tei06398/VisiStick-Arduino/Notes Worth Taking.docx

Notes Worth Taking

- Get a prototype
- Have a high success rate (at least 80%)
- Pick objects worth testing on
- What makes the test fail
