tei06398/VisiStick-Arduino/Stuff for Break.docx

https://www.homedepot.com/p/Everbilt-3-16-in-x-12-in-Cold-Rolled-Plain-Round-Rod-800407/204325644

https://basiccopper.com/thicknessguide.html
