tei06398/VisiStick-Arduino/Web Links.docx

Smart Cane (https://www.researchgate.net/publication/302405276_The_Smartcane_for_Blind_People_An_Electronically_Smart_Stick_to_Aid_Mobility)

Wet Surfaces Stats (https://safestart.com/news/heres-why-safety-pros-dont-stop-more-slips-trips-and-falls-happening-work/)

Falling (https://www.visionaware.org/blog/visually-impaired-now-what/protect-your-independence-create-a-fall-prevention-plan/12)

Blind Paths (https://psuchina.wordpress.com/2012/07/27/blind-lanes-in-china/)

Smart Cane 2 (http://assistech.iitd.ernet.in/smartcane.php)

Papers & Patents (http://assistech.iitd.ernet.in/index.php)

Sensors (https://www.intorobotics.com/types-sensors-target-detection-tracking/)

SmartCane Handle Patent

SHARP 2Y0A02 Datasheet (https://www.sparkfun.com/datasheets/Sensors/Infrared/gp2y0a02yk_e.pdf)
