tei06398/VisiStick-Arduino/Documents/Patents.docx

Patents

- Cane Handle (We are making our own handle)
- Axial Interlocking Cane (Not found)
- Split Architecture Design (Our sensor is not requiring other components to add onto the cane)
- Sensor Usage (Not an issue as the SmartCane sensor is on the handle while ours is not)
- Laser Radar Imaging - Object Detection: US20080309913A1 (We are not using lasers)
