tei06398/VisiStick-Arduino/Mechanics/Important Equations.docx

Important Equations:

Cg = m1x1 * m2x2…/ m(total)

Cg - Center of Gravity

m - Mass

x - Distance
