tei06398/VisiStick-Arduino/VisiStick (Inventor)/Electronics/ASM - Breakout Board Micro B.jpg

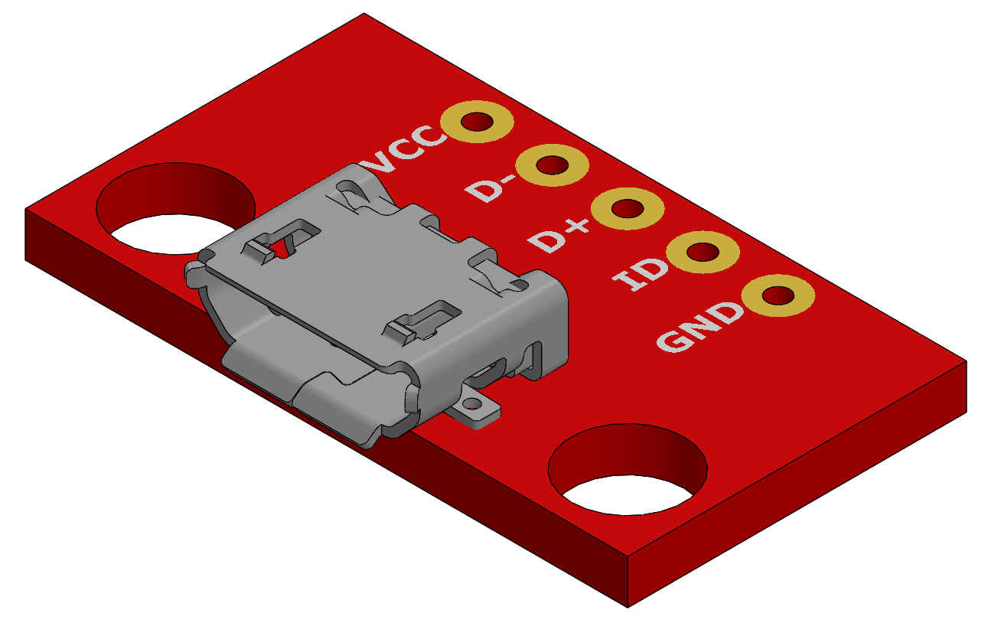
VisiStick (Inventor)/Electronics/ASM - Breakout Board Micro B.jpg
