tei06398/VisiStick-Arduino/Documents/Expenses.xlsx

Sheet: Expense Report
Begin Cumulative Labor Costs |  | Total Labor Costs: |  | $3373.50
Name |  | Hours | Hourly | Cost | Running Total
Seth |  | 112 | $10.00 | $1120.00 | $1120.00
Kyle |  | 107.25 | $10.00 | $1072.50 | $2192.50
DeSimony |  | 11.4 | $40.00 | $456.00 | $2648.50
Fitzgerald |  | 18.125 | $40.00 | $725.00 | $3373.50
End Cumulative Labor Costs
Part | Part Number | Quantity | Unit Price | Cost | Running Total | Section | Order
Begin Preexisting Parts
Arduino UNO | A000066 | 1 | $22.00 | $22.00 | $3395.50 | $22.00
Sharp Lidar Sensor | GP2Y0A02YK0F | 1 | $14.95 | $14.95 | $3410.45 | $36.95
End Preexisting Parts |  |  |  |  | $3410.45 |  | $36.95
Begin First DigiKey Order (12/18/18) (Sales Order #57795645) |  |  |  |  | $3410.45
Bluefruit LE UART Friend | 1528-1350-ND | 1 | $17.50 | $17.50 | $3427.95 | $17.50
LiIon Charger Board | 1528-1833-ND | 1 | $6.95 | $6.95 | $3434.90 | $24.45
USB C Breakout | 1568-1958-ND | 1 | $4.50 | $4.50 | $3439.40 | $28.95
USB MicroB Breakout | 1568-1192-ND | 1 | $4.25 | $4.25 | $3443.65 | $33.20
Battery 3.7V 2.5AH | 1528-1840-ND | 1 | $14.95 | $14.95 | $3458.60 | $48.15
Boost Converter | 1568-1155-ND | 1 | $15.95 | $15.95 | $3474.55 | $64.10
JST 2 Pin Cable | 1528-1126-ND | 1 | $0.75 | $0.75 | $3475.30 | $64.85
Rocker Switch | CH807-ND | 1 | $1.27 | $1.27 | $3476.57 | $66.12
End First DigiKey Order |  |  |  |  | $3476.57 |  | $66.12
Begin Home Depot Purchase (2/25/19) |  |  |  |  | $3476.57
Red Electrical Tape |  | 1 | $3.98 | $3.98 | $3480.55 | $3.98
WD-40 8 OZ |  | 1 | $4.27 | $4.27 | $3484.82 | $8.25
3 Foot 3/16" Dia. Steel Rod |  | 1 | $2.77 | $2.77 | $3487.59 | $11.02
Sales Tax |  | 1 | $0.88 | $0.88 | $3488.47 | $11.90
End Home Depot Purchase |  |  |  |  | $3488.47 |  | $11.90
Begin Michael's Purchase (2/25/19) |  |  |  |  | $3488.47
Copper Tape |  | 1 | $7.49 | $7.49 | $3495.96 | $7.49
Sales Tax |  | 1 | $0.60 | $0.60 | $3496.56 | $8.09
End Michael's Purchase |  |  |  |  | $3496.56 |  | $8.09
Begin Machining Job 1 (5/9/19)
.118" Lexan |  | 7.125 in2 | ?
.24" Lexan |  | 40 in2 | ?

Sheet: Hours Tracking
Date | Seth | Kyle | DeSimony | Fitzgerald | Cumulative Hours
2019-09-05 | 1.25 | 1.25 | 0 | 0 | Seth | Kyle | DeSimony | Fitzgerald
2019-09-07 | 1.25 | 1.25 | 0 | 0 | 112 | 107.25 | 11.4 | 18.125
2019-09-11 | 1.25 | 1.25 | 0 | 0
2019-09-13 | 1.25 | 1.25 | 0 | 0
2019-09-17 | 1.25 | 1.25 | 0 | 0
2019-09-19 | 1.25 | 1.25 | 0 | 0
2019-09-21 | 1.25 | 1.25 | 0 | 0
2019-09-25 | 1.25 | 1.25 | 0 | 0
2019-09-27 | 1.25 | 1.25 | 0 | 0
2019-10-01 | 1.25 | 1.25 | 0 | 0
2019-10-03 | 1.25 | 1.25 | 0 | 0
2019-10-05 | 1.25 | 1.25 | 0 | 0
2019-10-09 | 1.25 | 1.25 | 0 | 0
2019-10-11 | 1.25 | 0 | 0 | 0
2019-10-15 | 1.25 | 0 | 0 | 0
2019-10-17 | 1.25 | 0 | 0 | 0
2019-10-19 | 1.25 | 0 | 0 | 0
2019-10-23 | 1.25 | 0 | 0 | 0
2019-10-25 | 1.25 | 1.25 | 0 | 0
2019-10-29 | 1.25 | 1.25 | 0 | 0
2019-10-31 | 1.25 | 1.25 | 0 | 0
2019-11-02 | 1.25 | 1.25 | 0 | 0
2019-11-06 | 1.25 | 1.25 | 0 | 0
2019-11-08 | 1.25 | 1.25 | 0 | 0
2019-11-27 | 1.25 | 1.25 | 0 | 0
2019-11-29 | 1.25 | 1.25 | 0 | 0
2019-12-03 | 1.25 | 1.25 | 0 | 0
2019-12-05 | 1.25 | 1.25 | 0 | 0
2019-12-07 | 1.25 | 1.25 | 0 | 0
2019-12-11 | 1.25 | 1.25 | 0 | 0
2019-12-13 | 1.25 | 1.25 | 0 | 0
2019-12-17 | 1.25 | 1.25 | 0 | 0
2019-12-19 | 1.25 | 1.25 | 0 | 0
2019-12-21 | 1.25 | 1.25 | 0 | 0
2019-01-03 | 1.25 | 1.25 | 0 | 0
2019-01-07 | 1.25 | 1.25 | 0 | 0
2019-01-09 | 1.25 | 1.25 | 0 | 0
2019-01-11 | 1.25 | 1.25 | 0 | 0
2019-01-15 | 1.25 | 1.25 | 0 | 0
2019-01-17 | 1.25 | 1.25 | 0 | 0
2019-01-28 | 1.25 | 1.25 | 0 | 0
2019-01-30 | 0 | 1.25 | 0 | 0
2019-02-04 | 1.25 | 1.25 | 0 | 1.25
2019-02-05 | 0.5 | 0 | 0 | 0
2019-02-06 | 1.25 | 1.25 | 0 | 0.75
2019-02-08 | 1.25 | 2.5 | 0 | 1.25
2019-02-11 | 1.25 | 1.25 | 0.5 | 0.75
2019-02-13 | 1 | 1 | 0 | 0
2019-02-15 | 1.25 | 2.5 | 0 | 0
2019-02-25 | 3 | 3 | 0 | 0
2019-02-26 | 1.25 | 2.5 | 0 | 0
2019-02-27 | 1.25 | 0.75 | 0 | 0
2019-02-28 | 1.25 | 0 | 0 | 0
2019-03-04 | 1.25 | 1.25 | 0 | 0.75
2019-03-05 | 0.75 | 0 | 0 | 0
2019-03-06 | 1.25 | 2 | 0 | 0
2019-03-08 | 1.25 | 5 | 1 | 1
2019-03-12 | 1.25 | 1.25 | 0 | 0.75
2019-03-14 | 1.25 | 2 | 0.5 | 0.5
2019-03-18 | 1.25 | 2.5 | 0.5 | 0.5
2019-03-19 | 1 | 0 | 0 | 0
2019-03-20 | 1.25 | 2.5 | 0.5 | 0.25
2019-03-21 | 0 | 0.75 | 0 | 0
2019-03-25 | 1.25 | 1.25 | 0 | 1
2019-03-26 | 0.5 | 0 | 0 | 0
2019-03-27 | 2 | 2.5 | 0.75 | 1.25
2019-03-28 | 0.5 | 0 | 0 | 0
2019-03-29 | 1.25 | 2.5 | 1 | 1
2019-04-02 | 1.25 | 2.5 | 0 | 0
2019-04-04 | 1.25 | 2.5 | 0.75 | 1.25
2019-04-07 | 0.75 | 0 | 0 | 0
2019-04-08 | 2 | 1.25 | 0.25 | 0
2019-04-09 | 0.75 | 0 | 0 | 0
2019-04-10 | 2 | 0 | 0 | 0.75
2019-04-11 | 0.75 | 0 | 0 | 0
2019-04-12 | 2 | 2.5 | 0 | 0
2019-04-13 | 1.5 | 0 | 0 | 0
2019-04-14 | 1.5 | 0 | 0 | 0
2019-04-15 | 1 | 0 | 0 | 0
2019-04-16 | 2.75 | 1.25 | 0.375 | 0.375
2019-04-18 | 0 | 2 | 0.5 | 0
2019-04-30 | 3 | 2 | 0.375 | 0.5
2019-05-01 | 2.5 | 0 | 0 | 0
2019-05-02 | 1.25 | 2 | 0.5 | 1
2019-05-06 | 1.25 | 1.25 | 0.9 | 0.75
2019-05-07 | 1.25 | 0 | 0 | 0
2019-05-08 | 1.25 | 0.5 | 0.5 | 1
2019-05-09 | 0.5 | 2.5 | 2 | 1
2019-05-10 | 1.75 | 1.25 | 0.5 | 0.5
