tei06398/VisiStick-Arduino/VisiStick (Inventor)/Electronics/ASM - Breakout Board Micro B.STEP

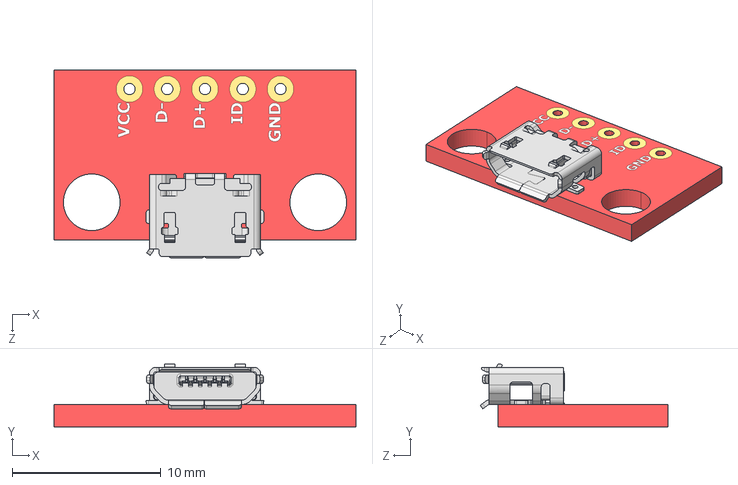
[picture p2: CAD file, 2019-10-01]
VisiStick (Inventor)/Electronics/ASM - Breakout Board Micro B.STEP
20.3 x 4.21 x 12.6 mm
Parts - PCB
Parts - micro_B
