tei06398/VisiStick-Arduino/VisiStick (Inventor)/Electronics/Parts - PCB.SLDPRT

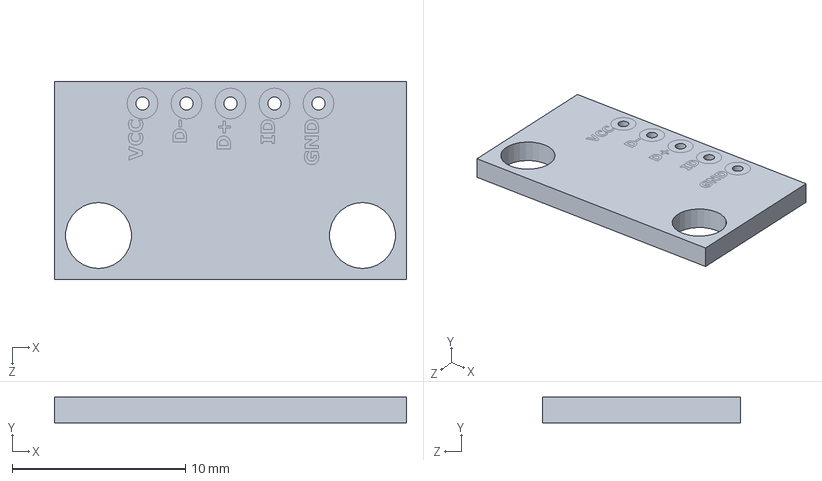
[picture p3: CAD file, 2019-10-01]
VisiStick (Inventor)/Electronics/Parts - PCB.SLDPRT
20.3 x 1.50 x 11.4 mm
