tei06398/VisiStick-Arduino/VisiStick (Inventor)/Electronics/S2B-PH-SM4-TB.SLDPRT

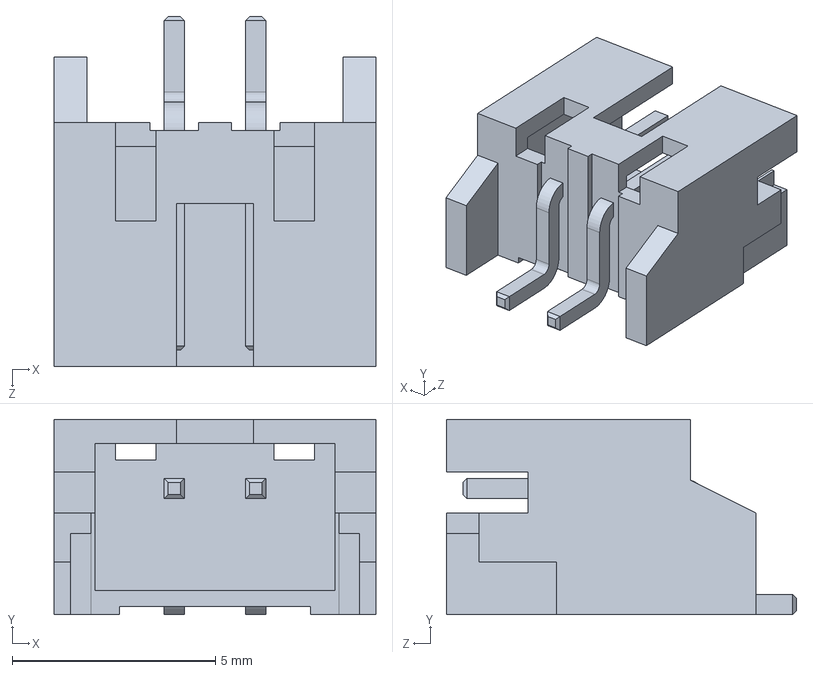
[picture p4: CAD file, 2019-10-01]
VisiStick (Inventor)/Electronics/S2B-PH-SM4-TB.SLDPRT
7.90 x 4.80 x 8.60 mm
