tei06398/VisiStick-Arduino/VisiStick (Inventor)/Electronics/.100 Header.SLDPRT

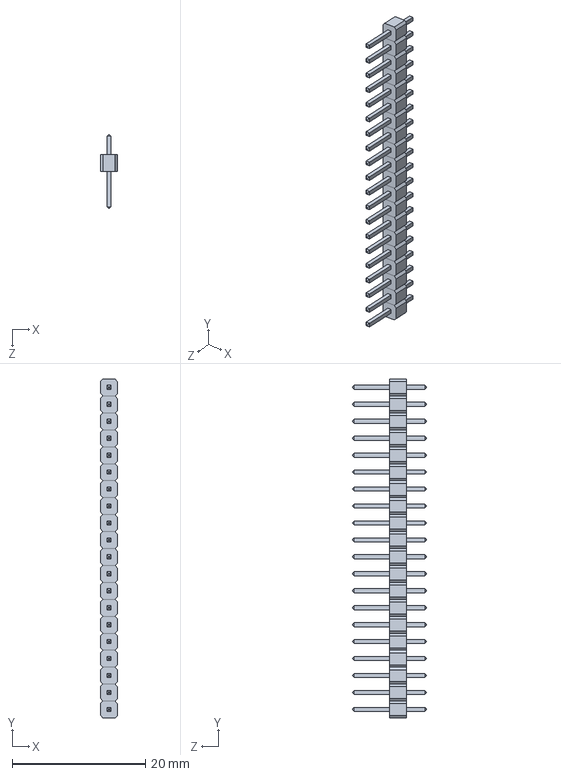
[picture p5: CAD file, 2019-10-01]
VisiStick (Inventor)/Electronics/.100 Header.SLDPRT
2.54 x 50.8 x 11.1 mm
