tei06398/VisiStick-Arduino/VisiStick (Inventor)/Electronics/Adafruit Micro Lipo wMicroUSB Jack - USB LiIonLiPoly charger.STEP

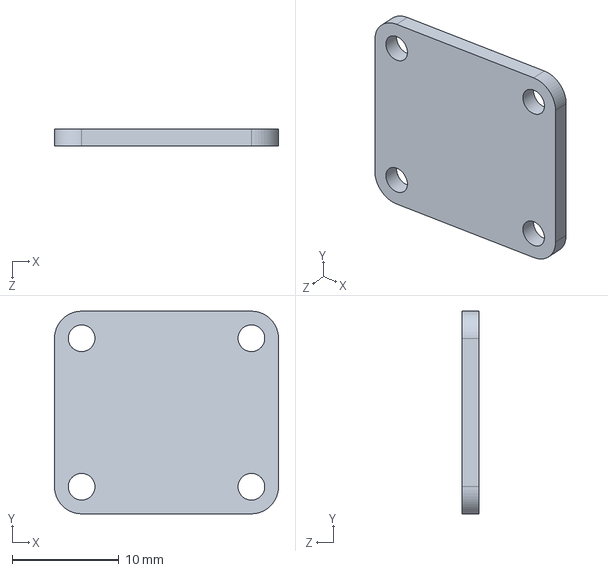
[picture p6: CAD file, 2019-10-01]
VisiStick (Inventor)/Electronics/Adafruit Micro Lipo wMicroUSB Jack - USB LiIonLiPoly charger.STEP
21.0 x 19.0 x 1.59 mm
