tei06398/VisiStick-Arduino/VisiStick (Inventor)/Electronics/Parts - micro_B.SLDPRT

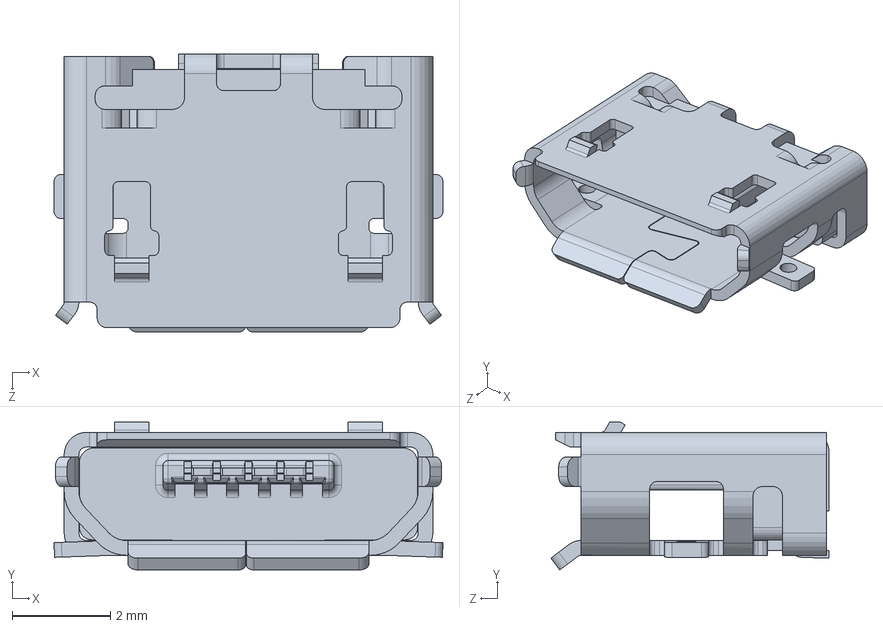
[picture p7: CAD file, 2019-10-01]
VisiStick (Inventor)/Electronics/Parts - micro_B.SLDPRT
7.91 x 3.01 x 5.66 mm
