tei06398/VisiStick-Arduino/VisiStick (Inventor)/Electronics/SPDT 30A switch.stp

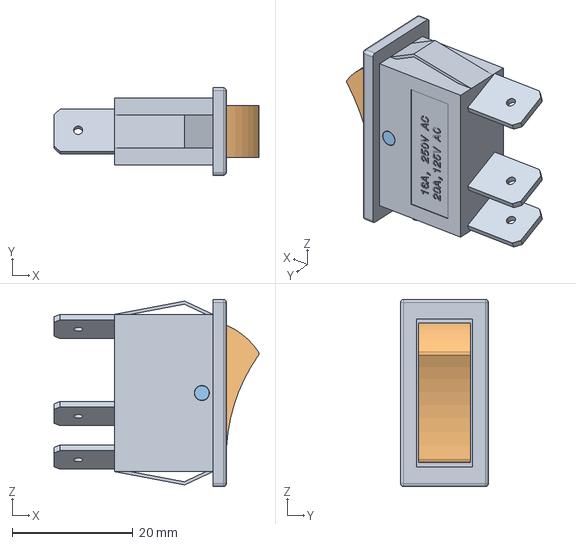
[picture p8: CAD file, 2019-10-01]
VisiStick (Inventor)/Electronics/SPDT 30A switch.stp
33.9 x 14.5 x 31.0 mm
