tei06398/VisiStick-Arduino/VisiStick (Inventor)/Electronics/Hirose Micro USB Digikey PN H11635CT-ND.SLDPRT

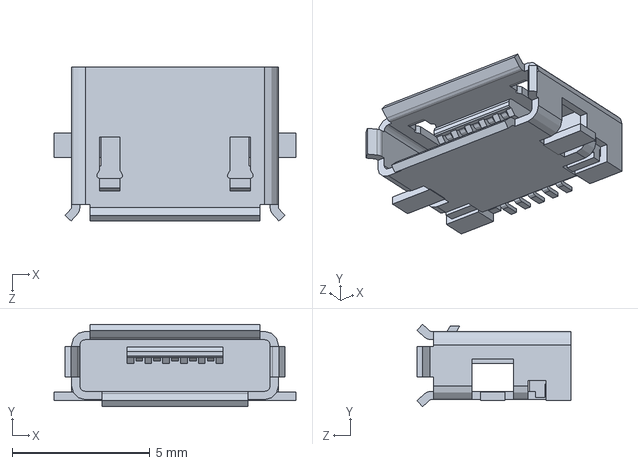
[picture p9: CAD file, 2019-10-01]
VisiStick (Inventor)/Electronics/Hirose Micro USB Digikey PN H11635CT-ND.SLDPRT
8.80 x 3.00 x 5.60 mm
