tei06398/VisiStick-Arduino/(list of files, cad)

Other CAD files:
Cane Adapter.ipt
OldVersions/Cane Adapter.0001.ipt
OldVersions/Cane Segment.0001.ipt
OldVersions/Lidar Holder 1.0001.ipt
VisiStick (Inventor)/Cane Segment.ipt
VisiStick (Inventor)/Case Final - Copy/Ball Bearing.ipt
VisiStick (Inventor)/Case Final - Copy/CNC Models.iam
VisiStick (Inventor)/Case Final - Copy/Lidar Sensor CAse Piece 1.ipt
VisiStick (Inventor)/Case Final - Copy/Lidar Sensor Case 4 v2 CNC.ipt
VisiStick (Inventor)/Case Final - Copy/Lidar Sensor Case Piece 2.ipt
VisiStick (Inventor)/Case Final - Copy/Lidar Sensor Case Piece 3.ipt
VisiStick (Inventor)/Case Final - Copy/Lidar Sensor Case Piece 4.ipt
VisiStick (Inventor)/Case Final - Copy/Needle Bearing Mount Connector 2.ipt
VisiStick (Inventor)/Case Final - Copy/Needle Bearing Mount Connector Rod.ipt
VisiStick (Inventor)/Case Final - Copy/Needle Bearing Mount v2.ipt
VisiStick (Inventor)/Case Final - Copy/OldVersions/Ball Bearing.0007.ipt
VisiStick (Inventor)/Case Final - Copy/OldVersions/CNC Models.0018.iam
VisiStick (Inventor)/Case Final - Copy/OldVersions/Lidar Sensor CAse Piece 1.0017.ipt
VisiStick (Inventor)/Case Final - Copy/OldVersions/Lidar Sensor Case 4 v2 CNC.0002.ipt
VisiStick (Inventor)/Case Final - Copy/OldVersions/Lidar Sensor Case Piece 2.0012.ipt
VisiStick (Inventor)/Case Final - Copy/OldVersions/Lidar Sensor Case Piece 3.0019.ipt
VisiStick (Inventor)/Case Final - Copy/OldVersions/Lidar Sensor Case Piece 4.0007.ipt
VisiStick (Inventor)/Case Final - Copy/OldVersions/Needle Bearing Mount Connector 2.0004.ipt
VisiStick (Inventor)/Case Final - Copy/OldVersions/Needle Bearing Mount Connector Rod.0001.ipt
VisiStick (Inventor)/Case Final - Copy/OldVersions/Needle Bearing Mount v2.0009.ipt
VisiStick (Inventor)/Case Final - Copy/OldVersions/Smaller Needle Bearing Mount.0014.ipt
VisiStick (Inventor)/Case Final - Copy/OldVersions/Steel Rod.0007.ipt
VisiStick (Inventor)/Case Final - Copy/Pivot Rod Washer.ipt
VisiStick (Inventor)/Case Final - Copy/Smaller Needle Bearing Mount.ipt
VisiStick (Inventor)/Case Final - Copy/Steel Rod.ipt
VisiStick (Inventor)/Case Final - Version 3/Ball Bearing.ipt
VisiStick (Inventor)/Case Final - Version 3/Lidar Sensor CAse Piece 1.ipt
VisiStick (Inventor)/Case Final - Version 3/Lidar Sensor Case Piece 2.ipt
VisiStick (Inventor)/Case Final - Version 3/Lidar Sensor Case Piece 3.ipt
VisiStick (Inventor)/Case Final - Version 3/Lidar Sensor Case Piece 4.ipt
VisiStick (Inventor)/Case Final - Version 3/Lidar Sensor Lexan Assembly.iam
VisiStick (Inventor)/Case Final - Version 3/Needle Bearing Mount v2.ipt
VisiStick (Inventor)/Case Final - Version 3/OldVersions/Ball Bearing.0002.ipt
VisiStick (Inventor)/Case Final - Version 3/OldVersions/Lidar Sensor CAse Piece 1.0017.ipt
VisiStick (Inventor)/Case Final - Version 3/OldVersions/Lidar Sensor Case Piece 2.0012.ipt
VisiStick (Inventor)/Case Final - Version 3/OldVersions/Lidar Sensor Case Piece 3.0012.ipt
VisiStick (Inventor)/Case Final - Version 3/OldVersions/Lidar Sensor Case Piece 4.0007.ipt
VisiStick (Inventor)/Case Final - Version 3/OldVersions/Lidar Sensor Lexan Assembly.0028.iam
VisiStick (Inventor)/Case Final - Version 3/OldVersions/Needle Bearing Mount v2.0009.ipt
VisiStick (Inventor)/Case Final - Version 3/OldVersions/Steel Rod.0002.ipt
VisiStick (Inventor)/Case Final - Version 3/Steel Rod.ipt
VisiStick (Inventor)/Case Final - Version 4/Ball Bearing.ipt
VisiStick (Inventor)/Case Final - Version 4/CNC Models.iam
VisiStick (Inventor)/Case Final - Version 4/Lidar Sensor CAse Piece 1.ipt
VisiStick (Inventor)/Case Final - Version 4/Lidar Sensor Case 4 v2 CNC.ipt
VisiStick (Inventor)/Case Final - Version 4/Lidar Sensor Case Piece 2.ipt
VisiStick (Inventor)/Case Final - Version 4/Lidar Sensor Case Piece 3.ipt
VisiStick (Inventor)/Case Final - Version 4/Lidar Sensor Case Piece 4.ipt
VisiStick (Inventor)/Case Final - Version 4/Lidar Sensor Lexan Assembly.iam
VisiStick (Inventor)/Case Final - Version 4/Needle Bearing Mount v2.ipt
VisiStick (Inventor)/Case Final - Version 4/OldVersions/Ball Bearing.0003.ipt
VisiStick (Inventor)/Case Final - Version 4/OldVersions/CNC Models.0017.iam
VisiStick (Inventor)/Case Final - Version 4/OldVersions/Lidar Sensor CAse Piece 1.0017.ipt
VisiStick (Inventor)/Case Final - Version 4/OldVersions/Lidar Sensor Case 4 v2 CNC.0002.ipt
VisiStick (Inventor)/Case Final - Version 4/OldVersions/Lidar Sensor Case Piece 2.0012.ipt
VisiStick (Inventor)/Case Final - Version 4/OldVersions/Lidar Sensor Case Piece 3.0018.ipt
VisiStick (Inventor)/Case Final - Version 4/OldVersions/Lidar Sensor Case Piece 4.0007.ipt
VisiStick (Inventor)/Case Final - Version 4/OldVersions/Lidar Sensor Lexan Assembly.0051.iam
VisiStick (Inventor)/Case Final - Version 4/OldVersions/Needle Bearing Mount v2.0009.ipt
VisiStick (Inventor)/Case Final - Version 4/OldVersions/Smaller Needle Bearing Mount.0007.ipt
VisiStick (Inventor)/Case Final - Version 4/OldVersions/Steel Rod.0003.ipt
VisiStick (Inventor)/Case Final - Version 4/Smaller Needle Bearing Mount.ipt
VisiStick (Inventor)/Case Final - Version 4/Steel Rod.ipt
VisiStick (Inventor)/Case Final OLD 3-20/Ball Bearing.ipt
VisiStick (Inventor)/Case Final OLD 3-20/Lidar Sensor CAse Piece 1.ipt
VisiStick (Inventor)/Case Final OLD 3-20/Lidar Sensor Case Piece 2.ipt
VisiStick (Inventor)/Case Final OLD 3-20/Lidar Sensor Case Piece 3.ipt
VisiStick (Inventor)/Case Final OLD 3-20/Lidar Sensor Case Piece 4.ipt
VisiStick (Inventor)/Case Final OLD 3-20/Lidar Sensor Lexan Assembly.iam
VisiStick (Inventor)/Case Final OLD 3-20/Needle Bearing Mount v2.ipt
VisiStick (Inventor)/Case Final OLD 3-20/OldVersions/Ball Bearing.0001.ipt
VisiStick (Inventor)/Case Final OLD 3-20/OldVersions/Lidar Sensor CAse Piece 1.0011.ipt
VisiStick (Inventor)/Case Final OLD 3-20/OldVersions/Lidar Sensor Case Piece 2.0008.ipt
VisiStick (Inventor)/Case Final OLD 3-20/OldVersions/Lidar Sensor Case Piece 3.0011.ipt
VisiStick (Inventor)/Case Final OLD 3-20/OldVersions/Lidar Sensor Case Piece 4.0007.ipt
VisiStick (Inventor)/Case Final OLD 3-20/OldVersions/Lidar Sensor Lexan Assembly.0018.iam
VisiStick (Inventor)/Case Final OLD 3-20/OldVersions/Needle Bearing Mount v2.0009.ipt
VisiStick (Inventor)/Case Final OLD 3-20/Steel Rod.ipt
VisiStick (Inventor)/Case Final OLD 3-20/T-Spacer .125 inch bore.ipt
VisiStick (Inventor)/Electronics/1904 Battery Charge Board.ipt
VisiStick (Inventor)/Electronics/2479 Adafruit Bluefruit LE UART Friend.ipt
VisiStick (Inventor)/Electronics/328 2500mAh battery.f3d
VisiStick (Inventor)/Electronics/328 Adafruit 2.5 Ah Lithium Battery.ipt
VisiStick (Inventor)/Electronics/ASM - Breakout Board Micro B.SLDASM
VisiStick (Inventor)/Electronics/ASM - Breakout Board Micro B.x_t
VisiStick (Inventor)/Electronics/Adafruit Micro Lipo wMicroUSB Jack - USB LiIonLiPoly charger.IGS
VisiStick (Inventor)/Electronics/Adafruit Micro Lipo wMicroUSB Jack - USB LiIonLiPoly charger.SLDASM
VisiStick (Inventor)/Electronics/Adafruit Micro Lipo wMicroUSB Jack - USB LiIonLiPoly charger.SLDPRT
VisiStick (Inventor)/Electronics/Adafruit Micro Lipo wMicroUSB Jack - USB LiIonLiPoly charger.ipt
VisiStick (Inventor)/Electronics/BOB-10031 USB Micro B Breakout.ipt
VisiStick (Inventor)/Electronics/Electronics Assemblies.iam
VisiStick (Inventor)/Electronics/Electronics Container Part 1.ipt
VisiStick (Inventor)/Electronics/Electronics Container Part 2.ipt
VisiStick (Inventor)/Electronics/Electronics Container Part 3.ipt
VisiStick (Inventor)/Electronics/Electronics Container Part 4.ipt
VisiStick (Inventor)/Electronics/Electronics Container Part 5.ipt
VisiStick (Inventor)/Electronics/OldVersions/328 Adafruit 2.5 Ah Lithium Battery.0001.ipt
VisiStick (Inventor)/Electronics/OldVersions/Sharp 2Y0A02 Case Lid.0001.ipt
VisiStick (Inventor)/Electronics/OldVersions/Sharp 2Y0A02.0004.ipt
VisiStick (Inventor)/Electronics/OldVersions/‎BOB-15100‎ USB C Breakout.0001.ipt
VisiStick (Inventor)/Electronics/SPDT 30A switch.ipt
VisiStick (Inventor)/Electronics/Sharp 2Y0A02.ipt
VisiStick (Inventor)/Electronics/Smaller Needle Bearing Mount.ipt
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
