tei06398/VisiStick-Arduino/VisiStick (Inventor)/Physical Parts/Lidar Sensor Assembly PDF.pdf

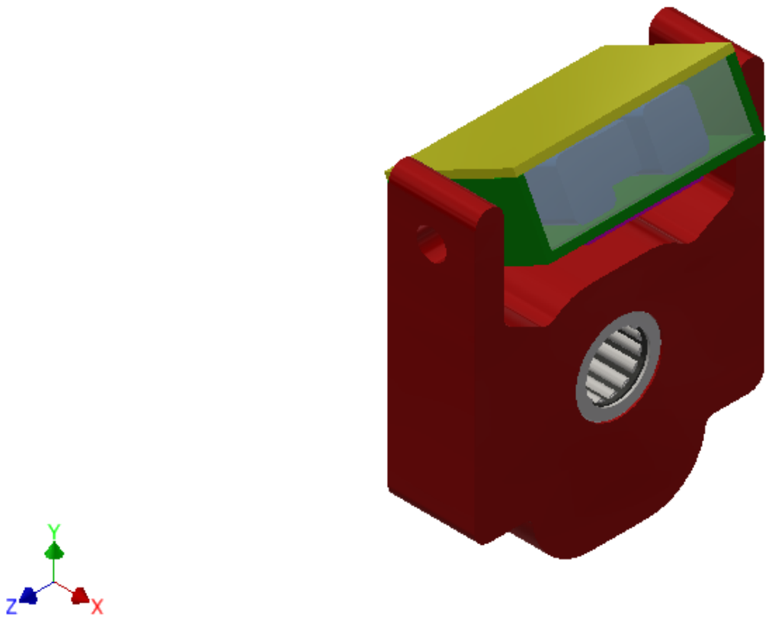
[picture p10: page 1]
