tei06398/VisiStick-Arduino/VisiStick (Inventor)/Physical Parts/Lidar Sensor Assembly Picture.bmp

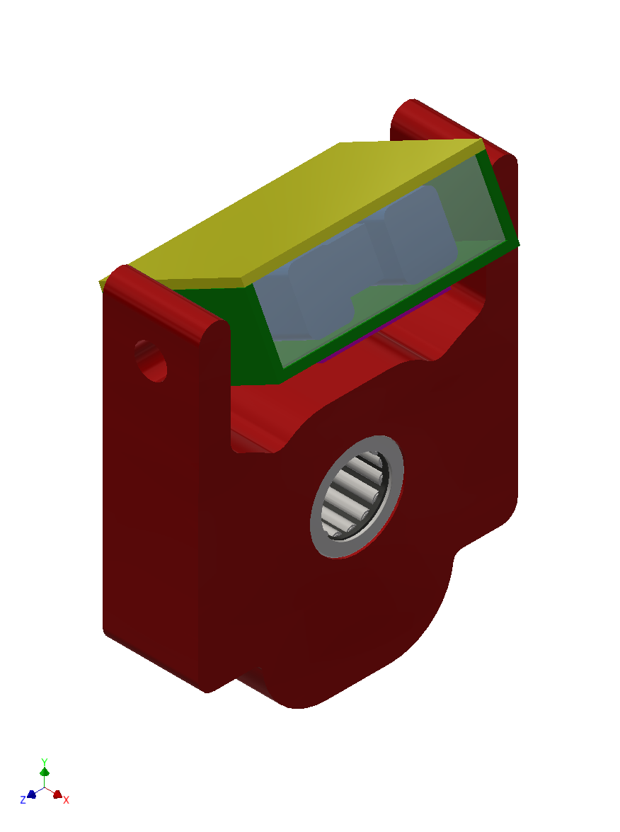
VisiStick (Inventor)/Physical Parts/Lidar Sensor Assembly Picture.bmp
