tei06398/VisiStick-Arduino/(list of files, drawings)

Other design files:
Electrical/Pinmaps/Pinmap ArduinoLidarBLE.fzz
